joanperelopez/CW-Keyer/IMAGES/Captura de pantalla 2023-06-16 a las 12.25.45.png

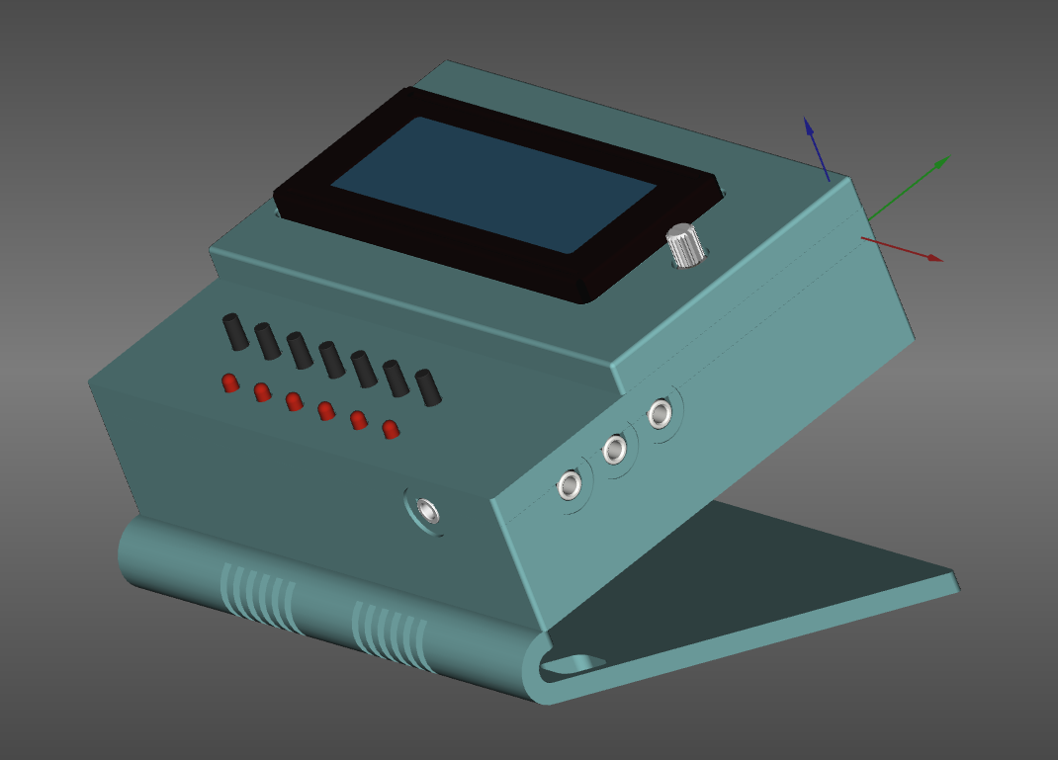
IMAGES/Captura de pantalla 2023-06-16 a las 12.25.45.png
