joanperelopez/CW-Keyer/IMAGES/Keyer_MEGA2560_Bot.png

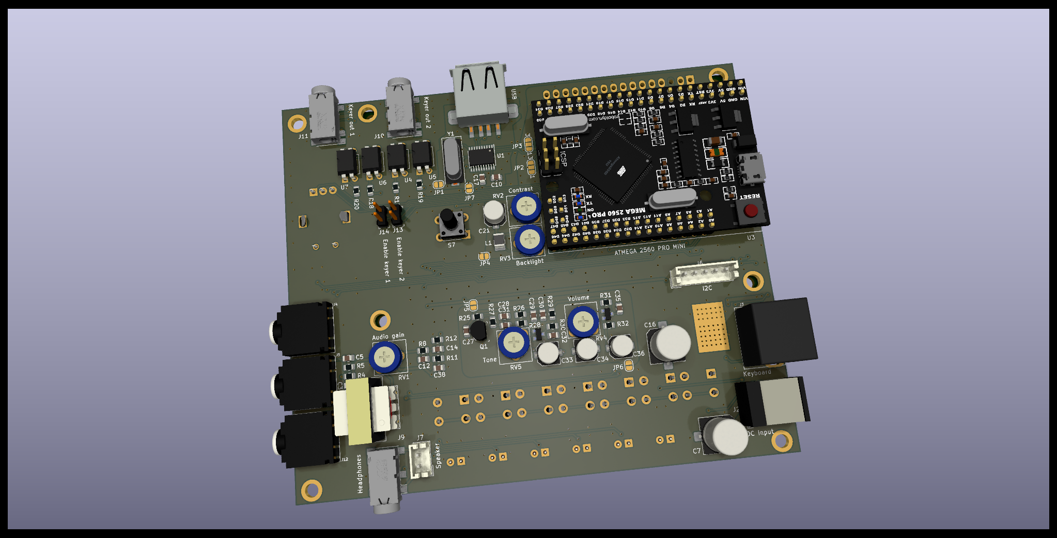
IMAGES/Keyer_MEGA2560_Bot.png
