joanperelopez/CW-Keyer/IMAGES/Captura de pantalla 2023-05-23 a las 14.10.53.png

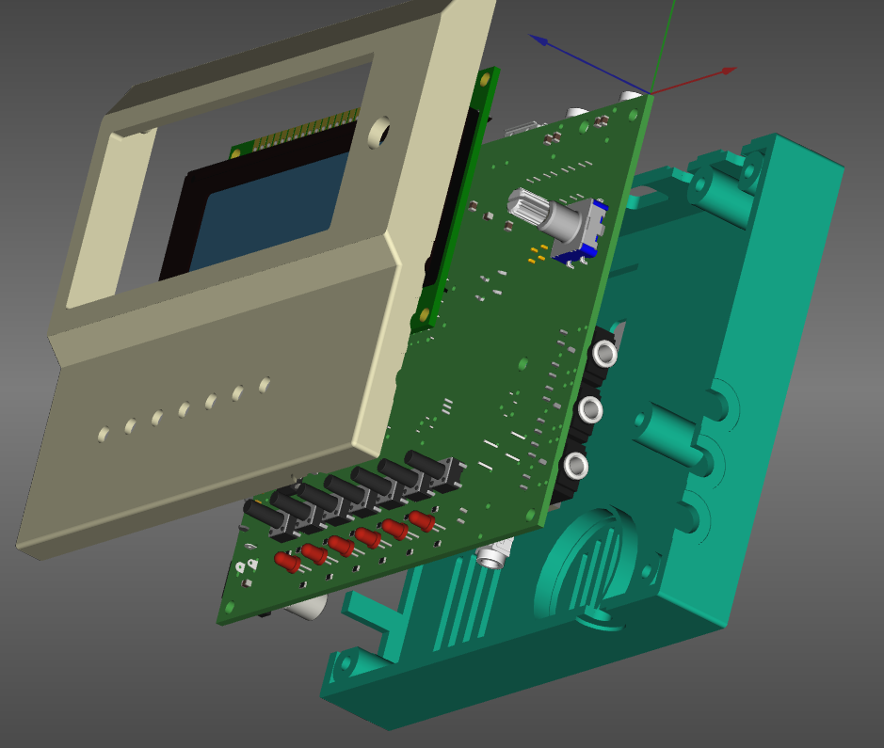
IMAGES/Captura de pantalla 2023-05-23 a las 14.10.53.png
