joanperelopez/CW-Keyer/IMAGES/Captura de pantalla 2023-05-23 a las 14.11.20.png

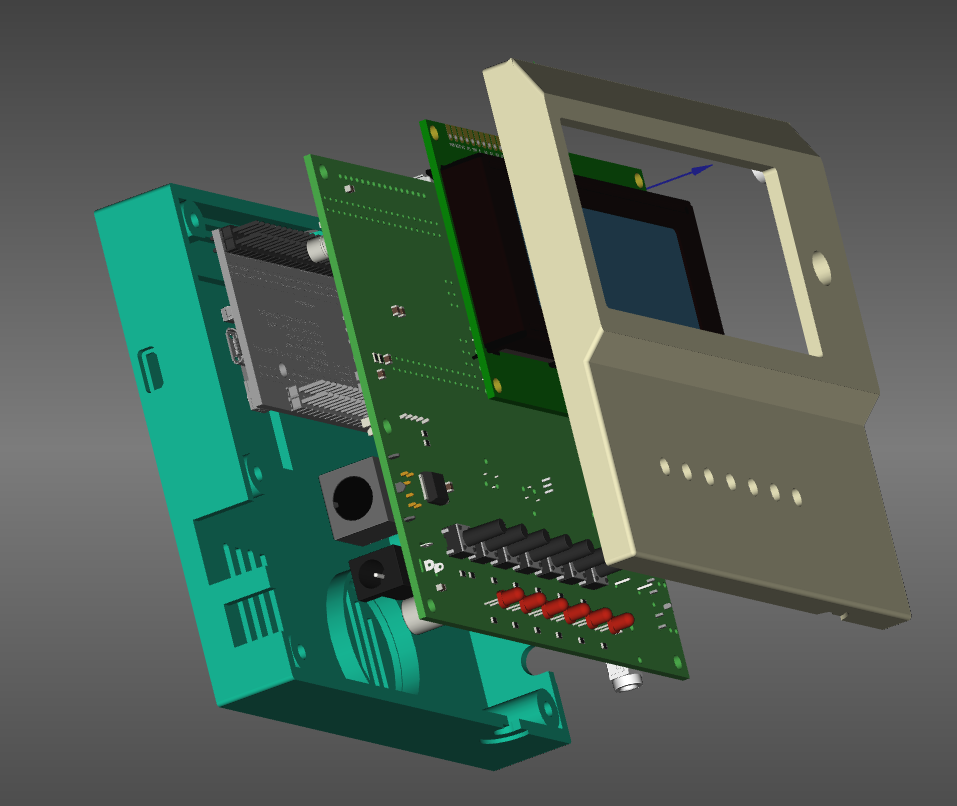
IMAGES/Captura de pantalla 2023-05-23 a las 14.11.20.png
