joanperelopez/CW-Keyer/IMAGES/Captura de pantalla 2023-06-16 a las 12.49.13.png

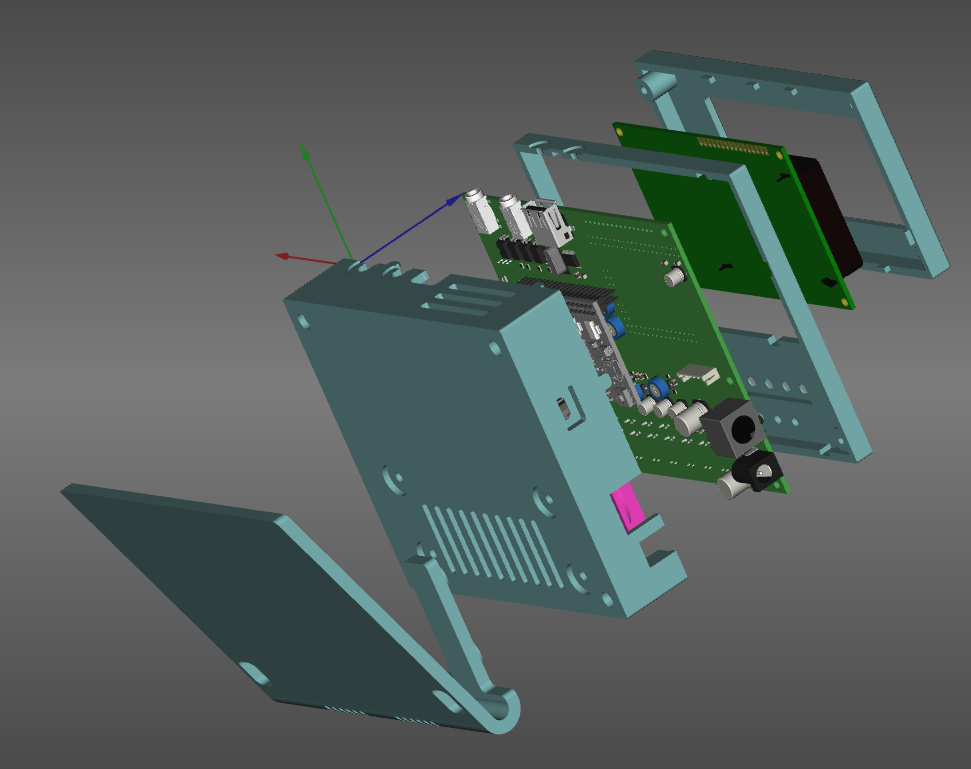
IMAGES/Captura de pantalla 2023-06-16 a las 12.49.13.png
