joanperelopez/CW-Keyer/IMAGES/Captura de pantalla 2023-06-16 a las 13.05.26.png

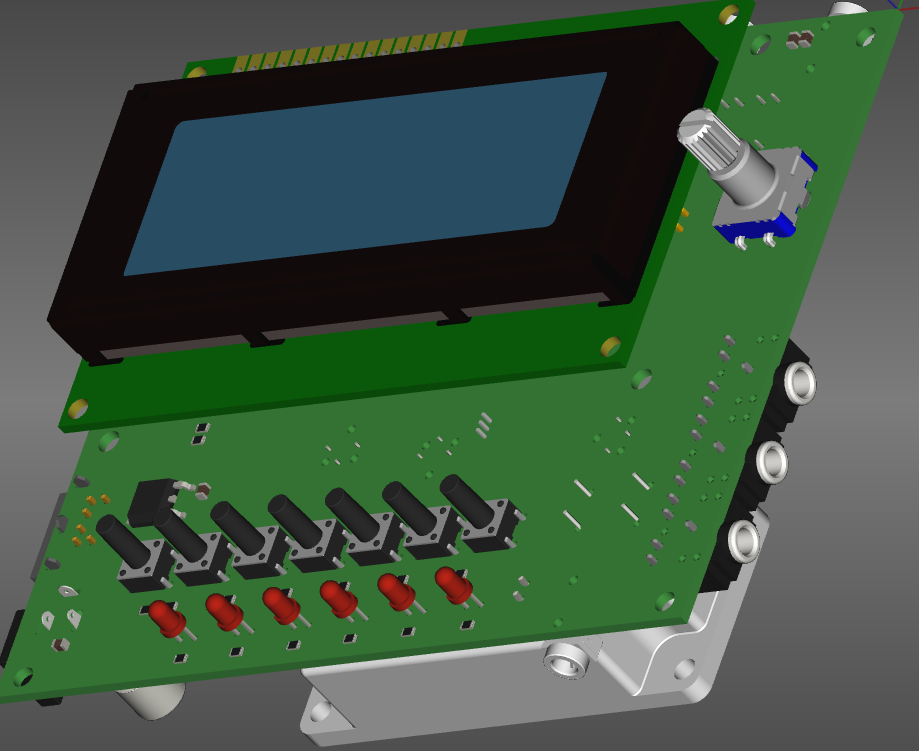
IMAGES/Captura de pantalla 2023-06-16 a las 13.05.26.png
