joanperelopez/CW-Keyer/IMAGES/Keyer_MEGA2560_top.png

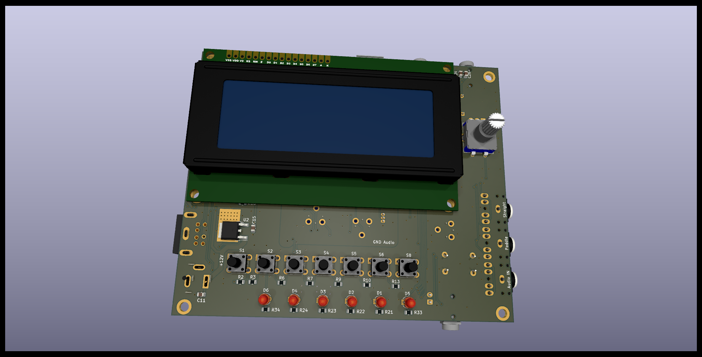
IMAGES/Keyer_MEGA2560_top.png
