joanperelopez/CW-Keyer/PCB/Captura de pantalla 2023-05-22 a las 11.54.25.png

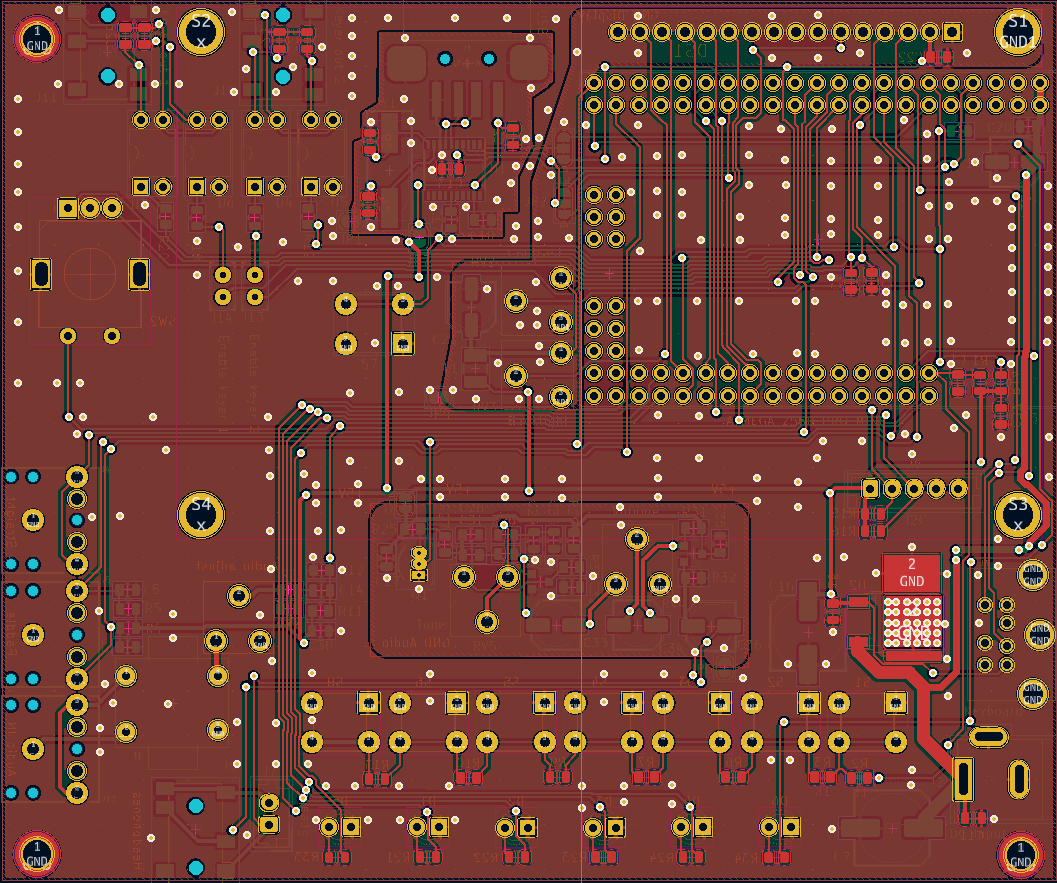
PCB/Captura de pantalla 2023-05-22 a las 11.54.25.png
