joanperelopez/CW-Keyer/PCB/Captura de pantalla 2023-05-22 a las 22.58.15.png

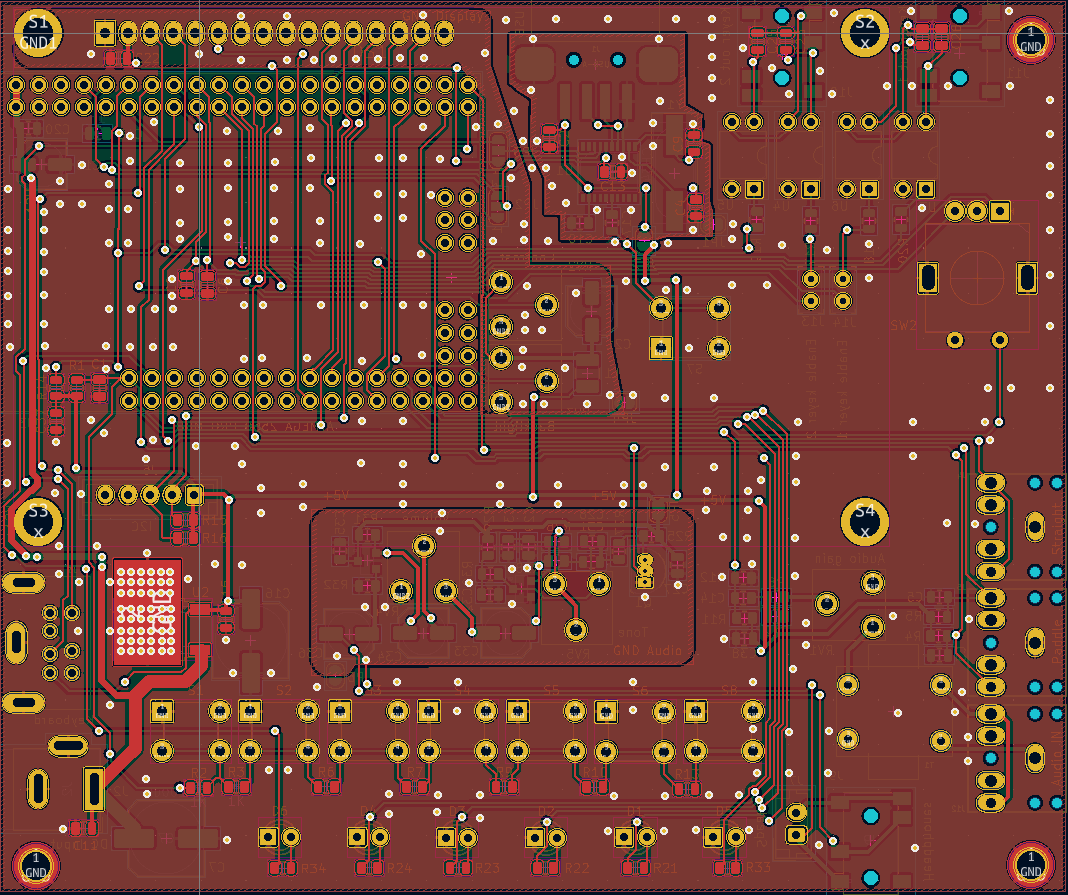
PCB/Captura de pantalla 2023-05-22 a las 22.58.15.png
