joanperelopez/CW-Keyer/STLs for PLA/Tapa_superior_keyer_A.stl

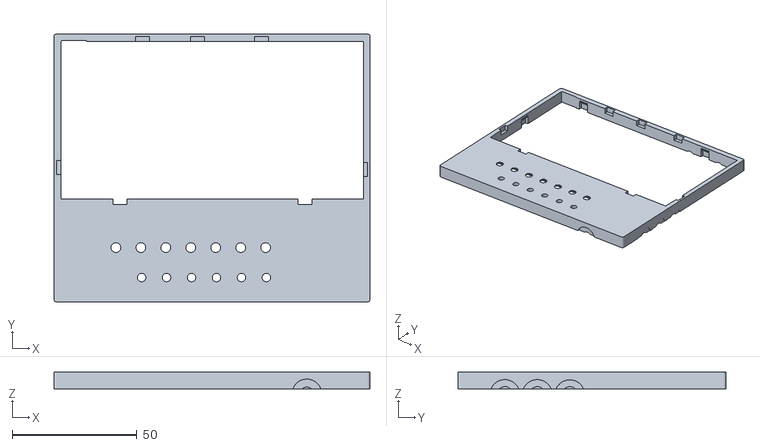
[picture p18: CAD file, 2023-07-27]
STLs for PLA/Tapa_superior_keyer_A.stl
126.6 x 107.4 x 6.70
