joanperelopez/CW-Keyer/STLs for PLA/Tapa_superior_keyer_B.stl

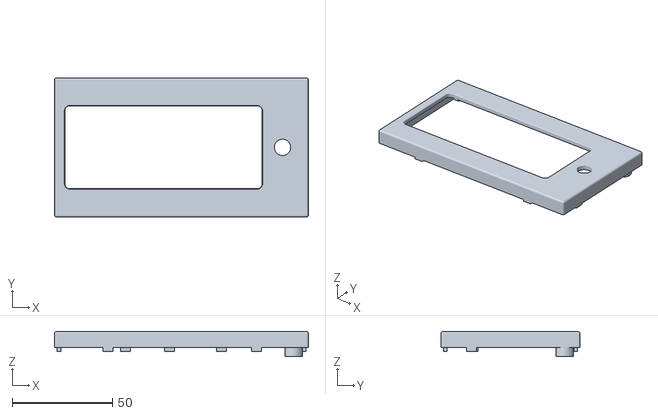
[picture p19: CAD file, 2023-07-27]
STLs for PLA/Tapa_superior_keyer_B.stl
126.6 x 69.4 x 12.5
