joanperelopez/CW-Keyer/STLs for PLA/Tapa_inferior_keyer.stl

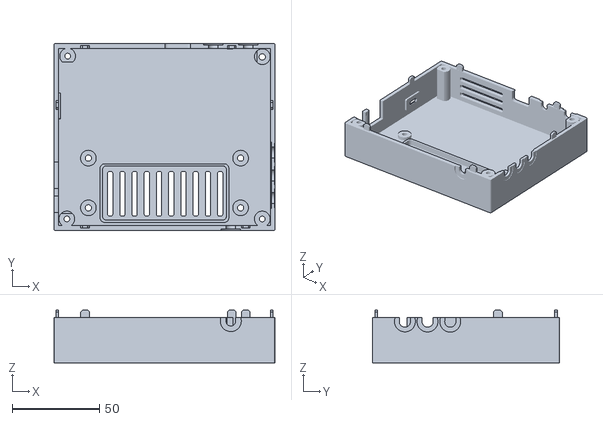
[picture p20: CAD file, 2023-07-27]
STLs for PLA/Tapa_inferior_keyer.stl
126.6 x 107.4 x 30.2
