joanperelopez/CW-Keyer/STLs for PLA/Pie_keyer.stl

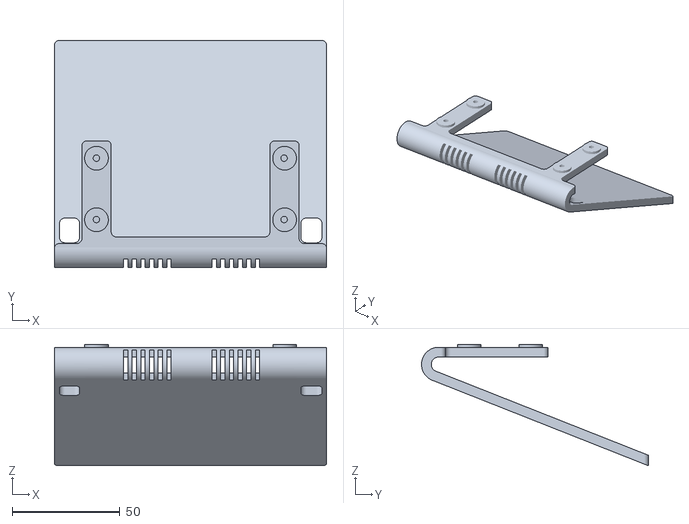
[picture p21: CAD file, 2023-07-27]
STLs for PLA/Pie_keyer.stl
126.0 x 105.1 x 56.3
