joanperelopez/CW-Keyer/SCHEMATIC/Keyer_MEGA2560_1.pdf

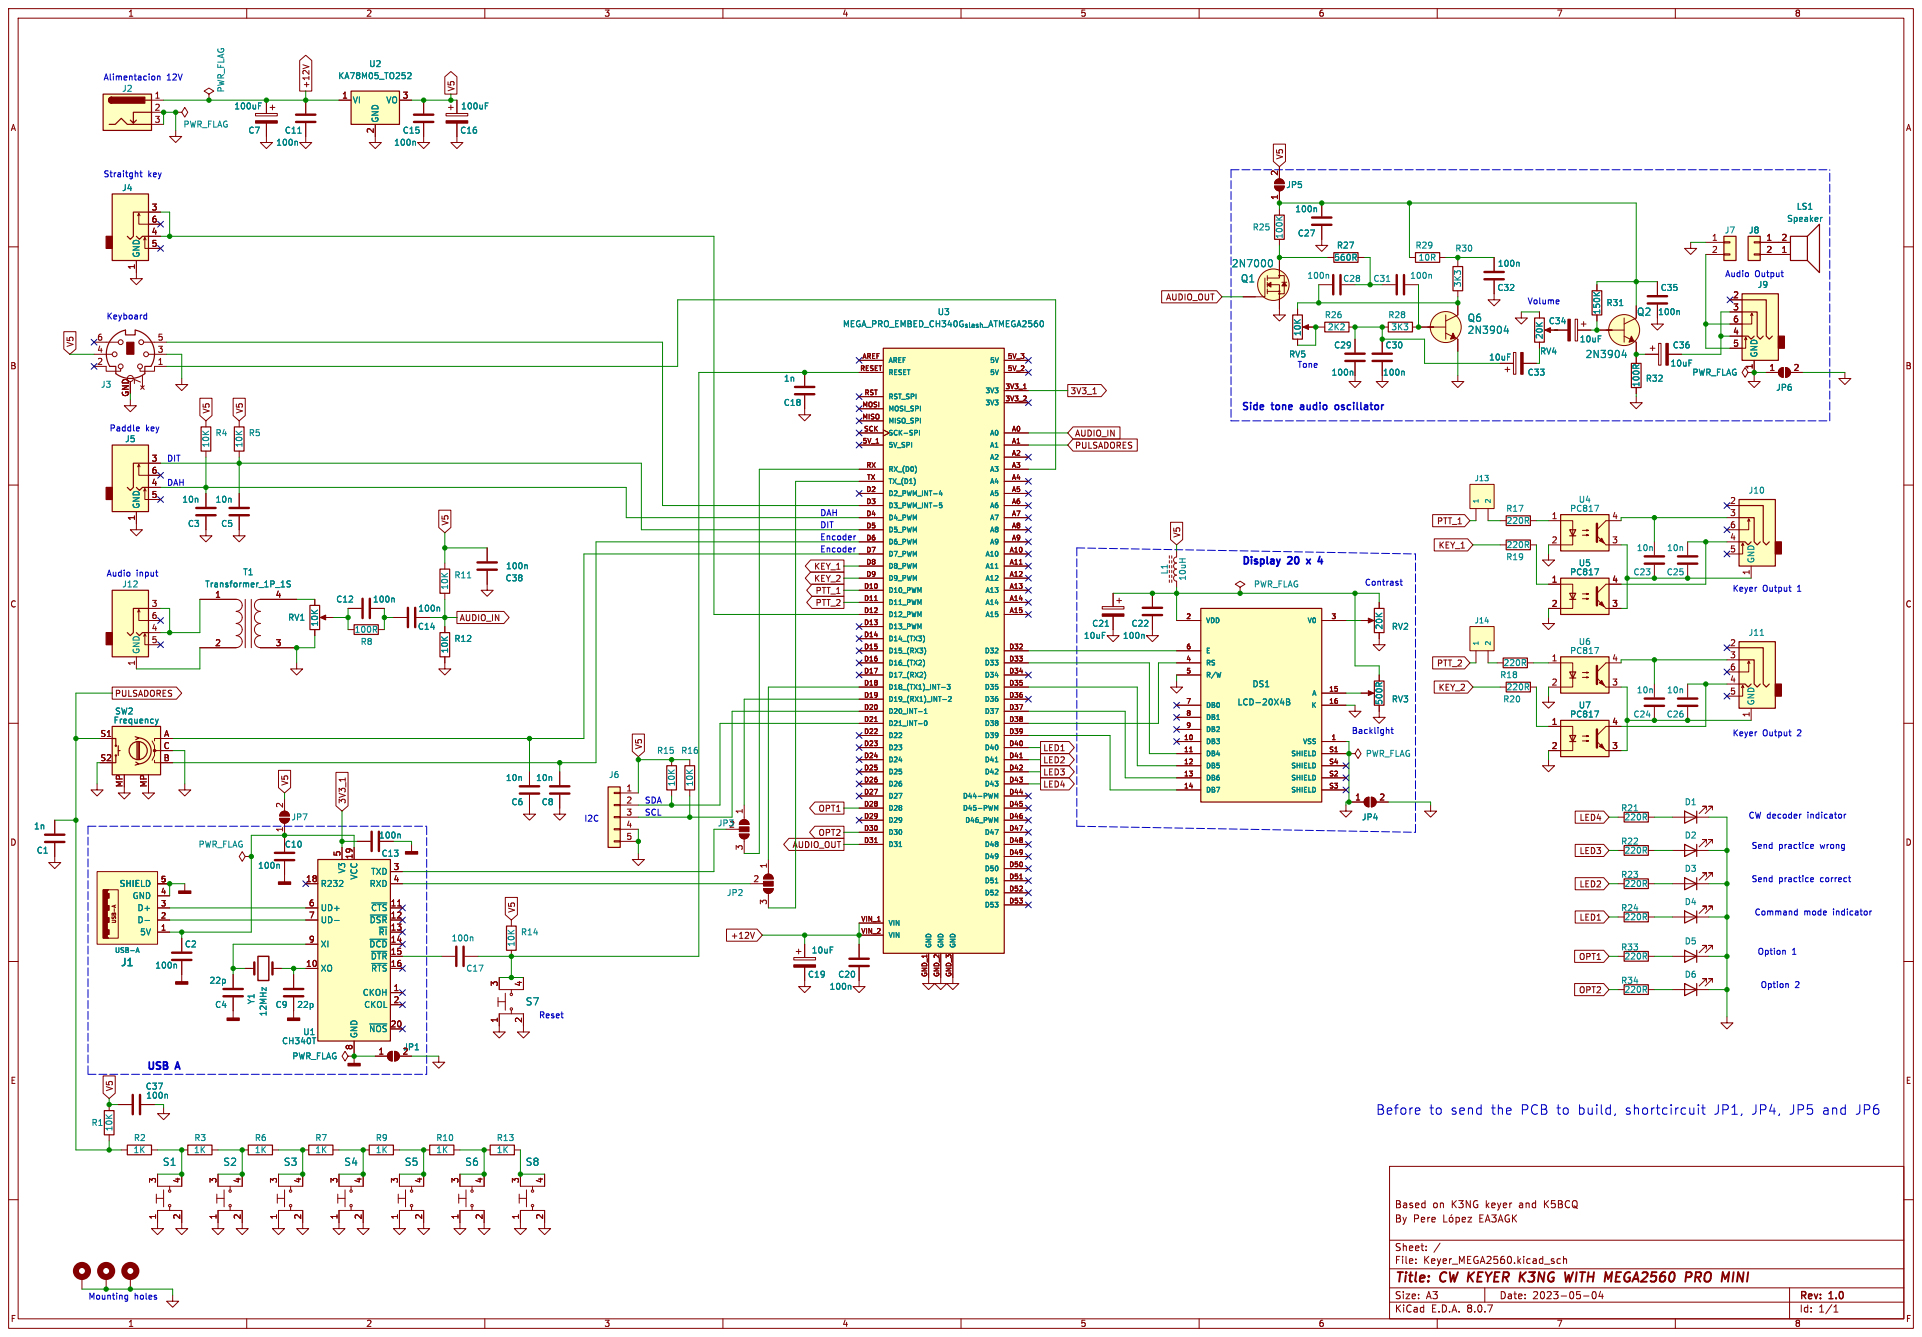
[picture p22: page 1]

Command mode indicator CW decoder indicator
