joanperelopez/CW-Keyer/SCHEMATIC/Keyer_MEGA2560_1.2.pdf

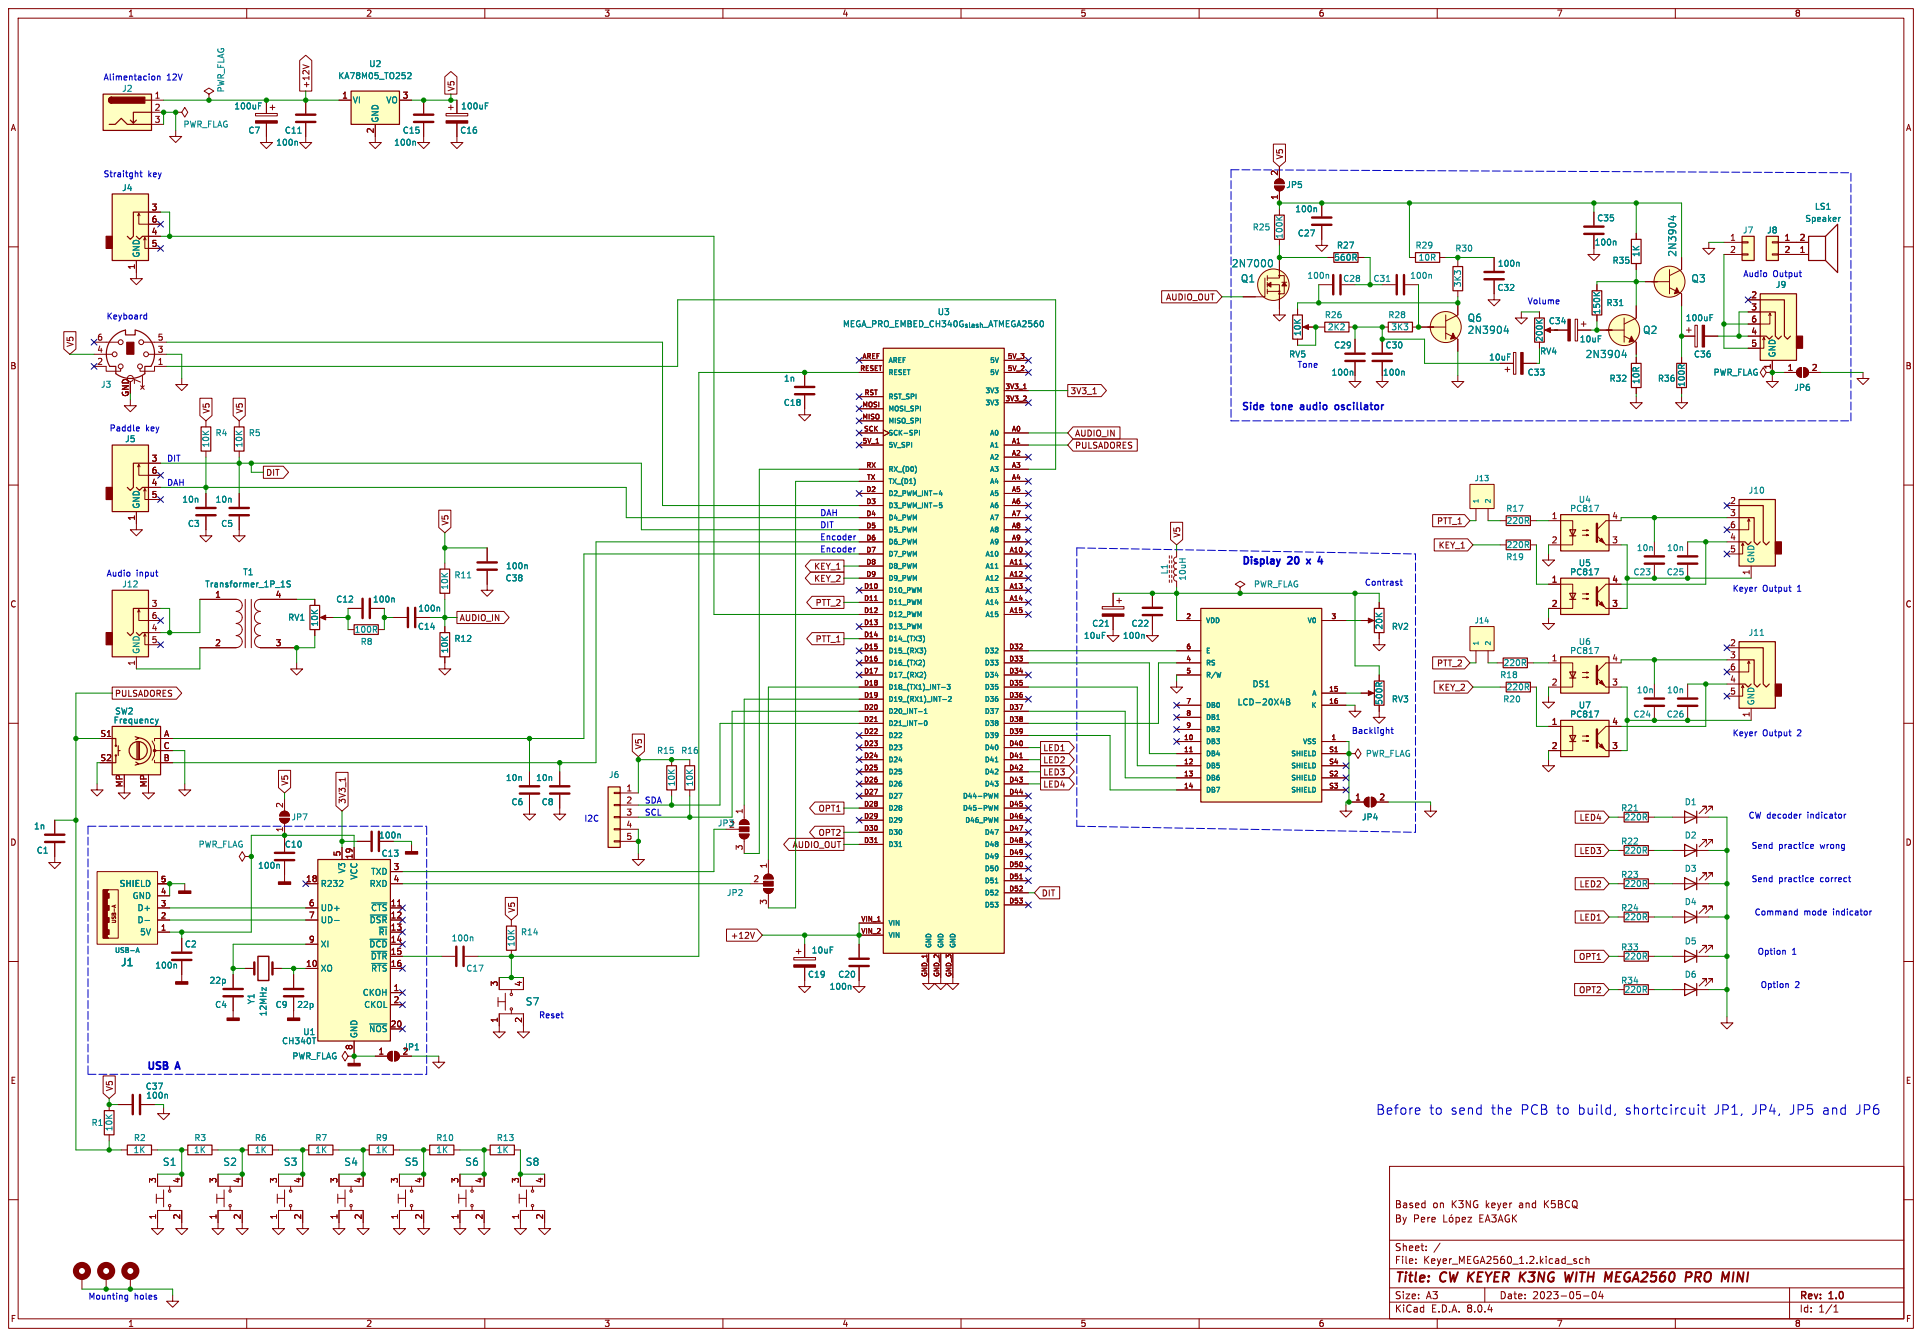
[picture p23: page 1]
