joanperelopez/CW-Keyer/SCHEMATIC/Keyer_MEGA2560.kicad_sch

## KiCad design SCHEMATIC/Keyer_MEGA2560.kicad_sch (2023-07-27)

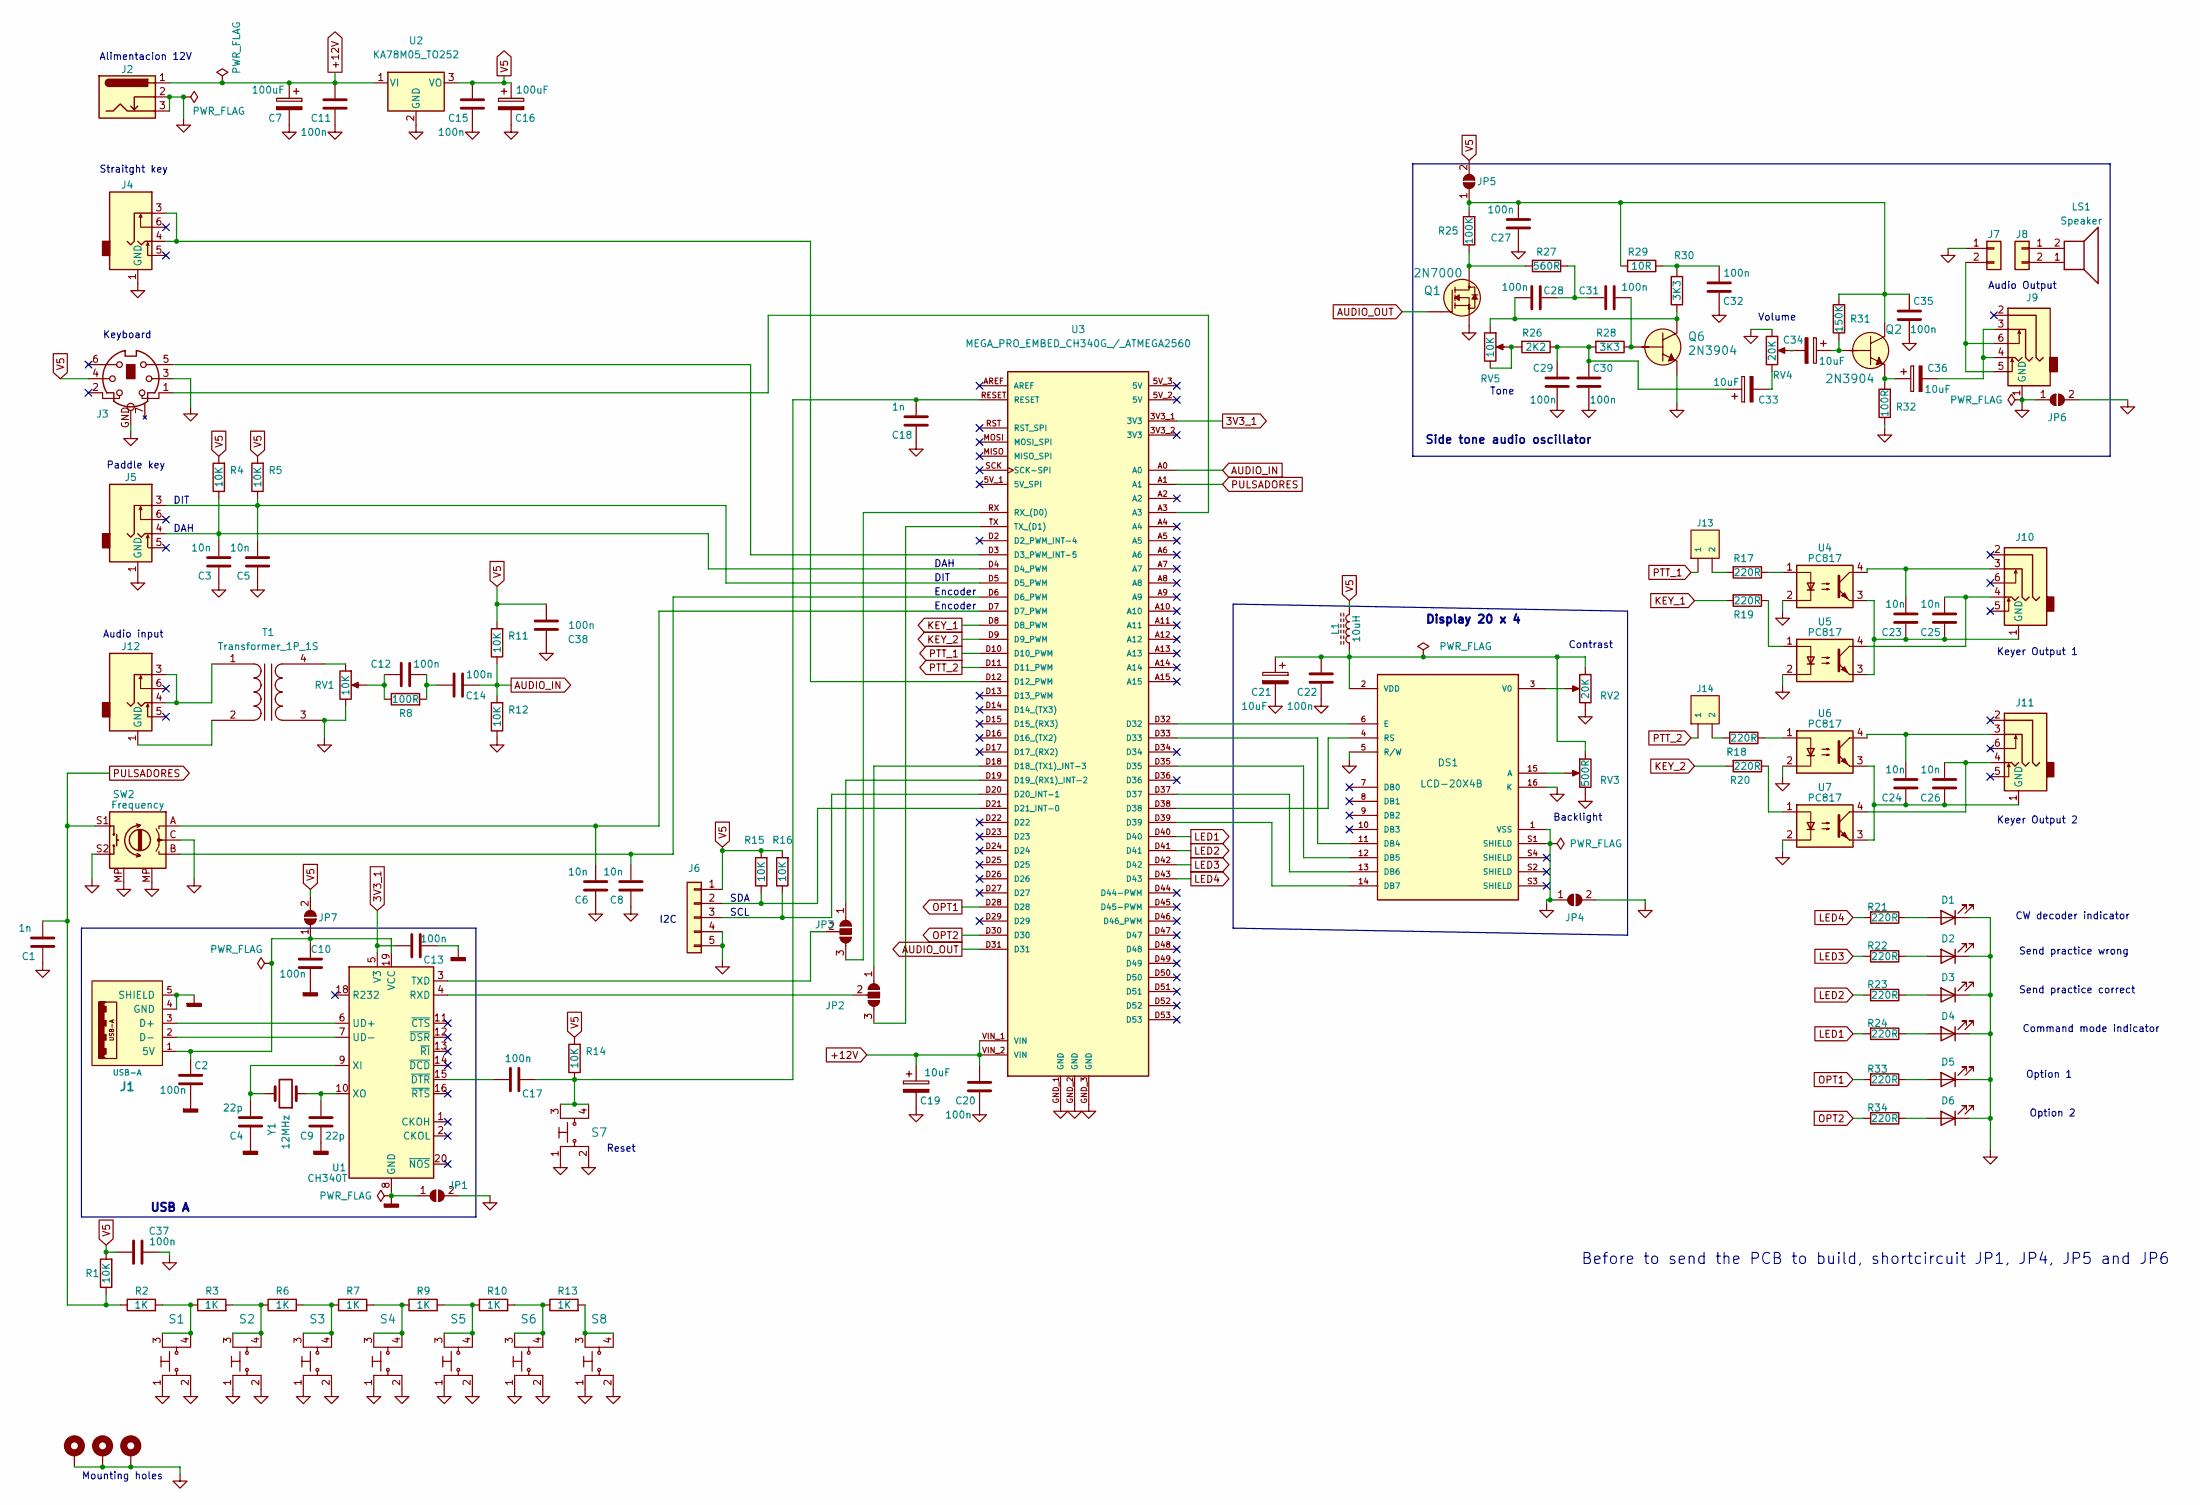
[picture p24: schematic Keyer_MEGA2560.kicad_sch]

Parts:
C1, C18: 1n; C_0805_2012Metric
C2, C10, C11, C12, C13, C14, C15, C17, C20, C22, C27, C28, C29, C30, C31, C32, C35, C37, C38: 100n; C_0805_2012Metric
C3, C5, C6, C8, C23, C24, C25, C26: 10n; C_0805_2012Metric
C4, C9: 22p; C_0805_2012Metric
C7, C16: 100uF; C_Elec_8x10.2
C19, C21, C33, C34, C36: 10uF; C_Elec_5x5.4
D1, D2, D3, D4, D5, D6: LED; LED_D3.0mm
DS1: LCD-20X4B; LCD_LCD-20X4B_PERE; PARTREV N/A
H1, H2, H3: MountingHole_Pad; MountingHole_3.2mm_M3_Pad_TopBottom
J1: USB-A; USB-A-SMT-8231-PEG_PERE
J2: Barrel_Jack_Switch_Pin3Ring; BarrelJack_GCT_DCJ200-10-A_Horizontal
J3: Mini-DIN-6; DIN7
J4, J5, J12: AudioJack4_PERE; AUDIO-JACK4
J6: Conn_01x05; JST_EH_B5B-EH-A_1x05_P2.50mm_Vertical
J7, J8: Conn_01x02; JST_EH_B2B-EH-A_1x02_P2.50mm_Vertical
J9, J10, J11: AudioJack3_PERE; Jack_3.5mm_PJ311_Horizontal
J13, J14: CONN_02; PinHeader_1x2_P2.54mm
JP1, JP4, JP5, JP6, JP7: SolderJumper_2_Open; SolderJumper-2_P1.3mm_Open_RoundedPad1.0x1.5mm
JP2, JP3: SolderJumper_3_Open; SolderJumper-3_P1.3mm_Open_RoundedPad1.0x1.5mm_NumberLabels
L1: 10uH; L_1210_3225Metric_Pad1.42x2.65mm_HandSolder
LS1: Speaker; PinHeader_2x11_P2.54mm_Vertical
Q1: 2N7000; TO-92-3; MPN 2N7000; Digi-Key_PN 2N7000FS-ND
Q2, Q6: 2N3904; SOT23-3; MPN 2N3904; Digi-Key_PN 2N3904CS-ND
R1, R4, R5, R11, R12, R14, R15, R16: 10K; R_0805_2012Metric
R2, R3, R6, R7, R9, R10, R13: 1K; R_0805_2012Metric
R8, R32: 100R; R_0805_2012Metric
R17, R18, R19, R20, R21, R22, R23, R24, R33, R34: 220R; R_0805_2012Metric
R25: 100K; R_0805_2012Metric
R26: 2K2; R_0805_2012Metric
R27: 560R; R_0805_2012Metric
R28, R30: 3K3; R_0805_2012Metric
R29: 10R; R_0805_2012Metric
R31: 150K; R_0805_2012Metric
RV1, RV5: 10K; Potentiometer_Piher_PT-10-V10_Vertical
RV2, RV4: 20K; Potentiometer_Piher_PT-10-V10_Vertical
RV3: 500R; Potentiometer_Piher_PT-10-V10_Vertical
S1, S2, S3, S4, S5, S6, S7, S8: 1825910-6; Switch_Tactile_THT_6x6mm; MPN 1825910-6; Digi-Key_PN 450-1650-ND
SW2: Frequency; RotaryEncoder_Alps_EC11E_Vertical_H20mm
T1: Transformer_1P_1S; Audio_transformer
U1: CH340T; SSOP-20_4.4x6.5mm_P0.65mm
U2: KA78M05_TO252; TO-252
U3: MEGA_PRO_EMBED_CH340G_/_ATMEGA2560; MODULE_MEGA_PRO_EMBED_CH340G___ATMEGA2560; PARTREV 12/May/2017
U4, U5, U6, U7: PC817; DIP-4_W7.62mm
Y1: 12MHz; Crystal_SMD_HC49-SD

Connections:
3V3_1: C13.2, U1.5 (V3), U3.3V3_1 (3V3)
+12V: C7.1, C11.2, C19.1, C20.2, J2.1, U2.1 (VI), U3.VIN_1 (VIN), U3.VIN_2 (VIN)
AUDIO_IN: C14.1, R11.1, R12.2, U3.A0
AUDIO_OUT: Q1.2 (G), U3.D31
GND: C1.1, C3.1, C5.1, C6.1, C7.2, C8.1, C11.1, C15.1, C16.2, C18.1, C19.2, C20.1, C37.1, C38.1, D1.1 (K), D2.1 (K), D3.1 (K), D4.1 (K), D5.1 (K), D6.1 (K), H1.1, H2.1, H3.1, J2.2, J2.3, J3.3, J3.GND, J4.1 (GND), J5.1 (GND), J6.4, J6.5, JP1.2 (B), JP4.2 (B), JP6.2 (B), R12.1, RV1.3, S1.1, S1.2, S2.1, S2.2, S3.1, S3.2, S4.1, S4.2, S5.1, S5.2, S6.1, S6.2, S7.1, S7.2, S8.1, S8.2, SW2.C, SW2.MP, SW2.S2, T1.3 (SA), U2.2 (GND), U3.GND_1 (GND), U3.GND_2 (GND), U3.GND_3 (GND), U4.2, U5.2, U6.2, U7.2
GND1: C21.2, C22.1, DS1.1 (VSS), DS1.5 (R/W), DS1.16 (K), DS1.S1 (SHIELD), JP4.1 (A), RV2.3, RV3.3
GND2: C27.1, C29.1, C30.1, C32.1, C35.1, J7.1, J9.1 (GND), JP6.1 (A), Q1.1 (S), Q6.2 (E), R32.1, RV4.1
GNDD: C2.2, C4.1, C9.1, C10.2, C13.1, J1.4 (GND), J1.5 (SHIELD), JP1.1 (A), U1.8 (GND)
KEY_1: R19.2, U3.D8 (D8_PWM)
KEY_2: R20.2, U3.D9 (D9_PWM)
LED1: R24.2, U3.D40
LED2: R23.2, U3.D41
LED3: R22.2, U3.D42
LED4: R21.2, U3.D43
unnamed: C3.2, J5.4, R4.1, U3.D4 (D4_PWM)
unnamed: C4.2, U1.9 (XI), Y1.2
unnamed: C5.2, J5.3, R5.1, U3.D5 (D5_PWM)
unnamed: C6.2, SW2.A, U3.D7 (D7_PWM)
unnamed: C8.2, SW2.B, U3.D6 (D6_PWM)
unnamed: C9.2, U1.10 (XO), Y1.1
unnamed: C2.1, C10.1, J1.1 (5V), JP7.1 (A), U1.19 (VCC)
unnamed: C12.1, C14.2, R8.2
unnamed: C12.2, R8.1, RV1.2
unnamed: C17.1, C18.2, R14.1, S7.3, S7.4, U3.RESET
unnamed: C17.2, U1.15 (~DTR)
unnamed: C21.1, C22.2, DS1.2 (VDD), L1.1, RV2.1, RV3.1
unnamed: C23.1, C25.1, J10.1 (GND), U4.3, U5.3
unnamed: C23.2, J10.3, U4.4
unnamed: C24.1, C26.1, J11.1 (GND), U6.3, U7.3
unnamed: C24.2, J11.3, U6.4
unnamed: C25.2, J10.4, U5.4
unnamed: C26.2, J11.4, U7.4
unnamed: C27.2, C35.2, JP5.1 (A), Q2.3 (C), R25.2, R29.2, R31.2
unnamed: C28.1, C31.2, R27.1
unnamed: C28.2, Q6.3 (C), R30.1, RV5.1
unnamed: C29.2, C30.2, C33.1, R26.1, R28.2
unnamed: C31.1, Q6.1 (B), R28.1
unnamed: C32.2, R29.1, R30.2
unnamed: C33.2, RV4.3
unnamed: C34.1, Q2.1 (B), R31.1
unnamed: C34.2, RV4.2
unnamed: C36.1, Q2.2 (E), R32.2
unnamed: C36.2, J9.3, J9.4
unnamed: D1.2 (A), R21.1
unnamed: D2.2 (A), R22.1
unnamed: D3.2 (A), R23.1
unnamed: D4.2 (A), R24.1
unnamed: D5.2 (A), R33.1
unnamed: D6.2 (A), R34.1
unnamed: DS1.3 (V0), RV2.2
unnamed: DS1.4 (RS), U3.D38
unnamed: DS1.6 (E), U3.D32
unnamed: DS1.11 (DB4), U3.D33
unnamed: DS1.12 (DB5), U3.D35
unnamed: DS1.13 (DB6), U3.D37
unnamed: DS1.14 (DB7), U3.D39
unnamed: DS1.15 (A), RV3.2
unnamed: J1.2 (D-), U1.7 (UD-)
unnamed: J1.3 (D+), U1.6 (UD+)
unnamed: J3.1, U3.A3
unnamed: J3.5, U3.D3 (D3_PWM_INT-5)
unnamed: J4.3, J4.4, U3.D12 (D12_PWM)
unnamed: J6.2, R15.1, U3.D21 (D21_INT-0)
unnamed: J6.3, R16.1, U3.D20 (D20_INT-1)
unnamed: J7.2, J9.5, J9.6
unnamed: J8.1, LS1.2
unnamed: J8.2, LS1.1
unnamed: J12.1 (GND), T1.2 (AB)
unnamed: J12.3, J12.4, T1.1 (AA)
unnamed: J13.2, R17.2
unnamed: J14.2, R18.2
unnamed: JP2.1 (A), U3.D18 (D18_(TX1)_INT-3)
unnamed: JP2.2 (C), U1.4 (RXD)
unnamed: JP2.3 (B), U3.TX (TX_(D1))
unnamed: JP3.1 (A), U3.D19 (D19_(RX1)_INT-2)
unnamed: JP3.2 (C), U1.3 (TXD)
unnamed: JP3.3 (B), U3.RX (RX_(D0))
unnamed: Q1.3 (D), R25.1, R27.2
unnamed: R2.2, R3.1, S1.3, S1.4
unnamed: R3.2, R6.1, S2.3, S2.4
unnamed: R6.2, R7.1, S3.3, S3.4
unnamed: R7.2, R9.1, S4.3, S4.4
unnamed: R9.2, R10.1, S5.3, S5.4
unnamed: R10.2, R13.1, S6.3, S6.4
unnamed: R13.2, S8.3, S8.4
unnamed: R17.1, U4.1
unnamed: R18.1, U6.1
unnamed: R19.1, U5.1
unnamed: R20.1, U7.1
unnamed: R26.2, RV5.2, RV5.3
unnamed: RV1.1, T1.4 (SB)
OPT1: R33.2, U3.D28
OPT2: R34.2, U3.D30
PTT_1: J13.1, U3.D10 (D10_PWM)
PTT_2: J14.1, U3.D11 (D11_PWM)
PULSADORES: C1.2, R1.1, R2.1, SW2.S1, U3.A1
V5: C15.2, C16.1, C37.2, C38.2, J3.4, J6.1, JP5.2 (B), JP7.2 (B), L1.2, R1.2, R4.2, R5.2, R11.2, R14.2, R15.2, R16.2, U2.3 (VO)

Notes on the sheet:
Alimentacion 12V
Send practice correct
Contrast
I2C
DIT
CW decoder indicator
Option 1
DAH
Straitght key
Paddle key
Before to send the PCB to build, shortcircuit JP1, JP4, JP5 and JP6
Keyer Output 1
Audio input
Audio Output
Keyer Output 2
Side tone audio oscillator
Option 2
SDA
Display 20 x 4
Tone
Encoder
SCL
DAH
Mounting holes
Keyboard
Volume
Send practice wrong
Reset
Backlight
Command mode indicator
USB A
