joanperelopez/CW-Keyer/SOFTWARE/k3ng_keyer_original/keyer_hardware.h

/*  keyer_hardware.h
  Edit this file to enable specific hardware profiles.
  When enabling a hardware option below, the default keyer_pin_settings.h, keyer_features_and_options.h, and keyer_settings.h files are not compiled.
  See the comments on each line to determine what files are compiled and should be customized.
*/

#define HARDWARE_K5BCQ   // edit these files: keyer_pin_settings_k5bcq.h, keyer_features_and_options_k5bcq.h, keyer_settings_k5bcq.h 

#define PRIMARY_SERIAL_CLS HardwareSerial
#define SECONDARY_SERIAL_CLS HardwareSerial 

  
